VEDA-4th-Team5/STM/STM/Core/Src/main.c

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
/* Includes ------------------------------------------------------------------*/
#include "main.h"
#include "cmsis_os.h"
#include "adc.h"
#include "dma.h"
#include "tim.h"
#include "usart.h"
#include "gpio.h"

/* USER CODE BEGIN Includes */
#include <stdio.h>
#include "arm_math.h"
#include <stdlib.h>
#include "sensor_queue.h"
#include "sensor_protocol.h"
#include "alert_command.h"
#include "lora_e22.h"
#include "lora_frame.h"
/* USER CODE END Includes */


/* USER CODE BEGIN PV */
volatile uint32_t tim2_tick_count = 0;

#define ADC_BUF_SIZE 64
uint16_t adc_buf[ADC_BUF_SIZE];
/* USER CODE END PV */

void SystemClock_Config(void);
void MX_FREERTOS_Init(void);
/* USER CODE BEGIN 0 */
int __io_putchar(int ch)
{
    HAL_UART_Transmit(&huart2, (uint8_t*)&ch, 1, HAL_MAX_DELAY);
    return ch;
}

/* Fires (from ISR context) every time the circular DMA buffer wraps, i.e.
 * once per full 1-second/64-sample window. Just signals TaskFlameSensor -
 * no heavy work here since we're in an interrupt handler. */
void HAL_ADC_ConvCpltCallback(ADC_HandleTypeDef *hadc)
{
  if (hadc->Instance == ADC1)
  {
    osSemaphoreRelease(adcBufReadySemHandle);
  }
}

/* Fires (from ISR context) on either edge of any of the 4 hall D0 pins.
 * Same shape as HAL_ADC_ConvCpltCallback above: just wake TaskHallSensor,
 * no debouncing or UART work here. Which of the 4 slots changed isn't
 * tracked -- the task re-scans all 4 on wake, same as the old poll loop
 * did every tick. */
void HAL_GPIO_EXTI_Callback(uint16_t GPIO_Pin)
{
  if (GPIO_Pin == HALL1_D0_Pin || GPIO_Pin == HALL2_D0_Pin ||
      GPIO_Pin == HALL3_D0_Pin || GPIO_Pin == HALL4_D0_Pin)
  {
    osSemaphoreRelease(hallEdgeSemHandle);
  }
}

/* Fires (from ISR context) once per received USART2 byte -- the link runs
 * one-byte-at-a-time interrupt mode (see AlertCommand_StartReceive()), not
 * DMA, since AlertCommand traffic is short and infrequent. All the actual
 * buffering/parsing is delegated to alert_command.c; this callback only
 * exists because HAL_UART_RxCpltCallback has to live somewhere, same as
 * HAL_ADC_ConvCpltCallback and HAL_GPIO_EXTI_Callback above. */
void HAL_UART_RxCpltCallback(UART_HandleTypeDef *huart)
{
  if (huart->Instance == USART2)
  {
    AlertCommand_OnByteReceived();
  }
  else if (huart->Instance == USART1)
  {
    /* LoRa 하행. 여기서는 링버퍼에 넣기만 하고, 프레임 조립과 CRC 검증은
     * StartDefaultTask 가 태스크 문맥에서 한다 -- USART2 경로가 파싱을
     * 태스크로 미루는 것과 같은 이유다. */
    LoRa_OnByteReceived();
  }
}

/* 수신 에러(주로 오버런/프레이밍)가 나면 HAL 은 수신을 중단하고 *재무장하지
 * 않는다.* 그대로 두면 그 순간부터 하행이 조용히 죽는다 -- 로그도 안 남고
 * 송신은 멀쩡해서 원인을 찾기 어렵다. 여기서 다시 걸어준다.
 *
 * 오버런은 인터럽트가 잠깐 지연되면(예: 송신 중 스케줄러 정지 구간) 실제로
 * 발생한다. 이 콜백이 없으면 몇 시간 안에 반드시 겪는다. */
void HAL_UART_ErrorCallback(UART_HandleTypeDef *huart)
{
  if (huart->Instance == USART2)
  {
    __HAL_UART_CLEAR_OREFLAG(huart);
    AlertCommand_StartReceive();
  }
  else if (huart->Instance == USART1)
  {
    __HAL_UART_CLEAR_OREFLAG(huart);
    LoRa_StartReceiveIT();
  }
}
/* USER CODE END 0 */

/**
  * @brief  The application entry point.
  * @retval int
  */
int main(void)
{
  /* MCU Configuration--------------------------------------------------------*/

  /* Reset of all peripherals, Initializes the Flash interface and the Systick. */
  HAL_Init();

  /* Configure the system clock */
  SystemClock_Config();

  /* Initialize all configured peripherals */
  MX_GPIO_Init();
  MX_DMA_Init();
  MX_ADC1_Init();
  MX_USART2_UART_Init();
  MX_TIM2_Init();
  /* USER CODE BEGIN 2 */
#if LORA_BURN_MODULE
  /* Pi 쪽 모듈처럼 MCU 없이 동작할 모듈을 준비하는 전용 모드.
   * 굽고 확인한 뒤 여기서 멈춘다 -- 센서 노드로 동작하지 않으므로 이 모드를
   * 켜둔 채 잊어버려도 바로 알아차릴 수 있다. */
  LoRa_Init();
  printf("\r\n");
  printf("##################################################\r\n");
  printf("#  LORA BURN MODE -- 센서 동작 안 함              \r\n");
  printf("#  주소 0x%04X / NETID 0x%02X                     \r\n",
         (unsigned)LORA_BURN_ADDRESS, (unsigned)LORA_BURN_NETID);
  printf("#  ch=%u / 10dBm / LBT on / 62.5k / 115200        \r\n",
         (unsigned)LORA_CH_DATA_DEFAULT);
  printf("#  C0(영구 저장) -- 전원 끊어도 유지됨            \r\n");
  printf("##################################################\r\n");

  {
    HAL_StatusTypeDef burn_st = LoRa_BurnModule(LORA_BURN_ADDRESS, LORA_BURN_NETID);

    if (burn_st == HAL_OK)
    {
      printf("\r\n[burn] 완료. 되읽기 대조까지 통과했습니다.\r\n");
      LoRa_SelfTest();   /* 최종 상태를 디코드해서 한 번 더 남긴다 */
      printf("\r\n이 모듈을 대상 보드로 옮기고, LORA_BURN_MODULE 을 0 으로\r\n");
      printf("되돌린 뒤 재빌드하세요.\r\n");
    }
    else
    {
      printf("\r\n[burn] 실패. 모듈을 옮기지 마세요.\r\n");
      printf("배선(모듈TXD->PA10 / 모듈RXD->PA9 / M0->PC7 / M1->PB6 / AUX->PA7 / 3V3 / GND) 확인 후 재시도.\r\n");
    }

    /* 센서 동작으로 넘어가지 않는다. LED 로 결과를 표시하며 정지:
     * 느린 깜빡임 = 성공, 빠른 깜빡임 = 실패. */
    for (;;)
    {
      HAL_GPIO_TogglePin(LD2_GPIO_Port, LD2_Pin);
      HAL_Delay((burn_st == HAL_OK) ? 1000 : 150);
    }
  }
#endif

  /* 빌드 배너.
   *
   * 플래시가 실제로 새 빌드로 갈렸는지 로그만 보고는 알 수 없어서, 옛 펌웨어를
   * 돌리며 "왜 새 기능이 안 보이지" 를 몇 번 반복했다. 부팅할 때마다 빌드
   * 시각과 켜져 있는 기능을 찍어두면 그 혼선이 사라진다. */
  printf("\r\n======================================================\r\n");
  /* 보드 이름은 하드코딩하지 않는다. STM1/STM2 펌웨어가 같은 코드라
   * 여기가 고정이면 두 보드가 똑같은 이름으로 찍혀서, 어느 쪽 로그를 보고
   * 있는지 헷갈린다. 콘솔이 두 개 열려 있을 때 특히 위험하다. */
  printf("# %s  build %s %s\r\n", SENSOR_NODE_ID, __DATE__, __TIME__);
  printf("# payload v1.1 (frame ver 0x%02X) / node %s\r\n",
         (unsigned)LORA_FRAME_VERSION, SENSOR_NODE_ID);
  printf("# TX  uart=%d lora=%d   LoRa ch=%u pwr=10dBm lbt=%d\r\n",
         SENSOR_TX_UART, SENSOR_TX_LORA,
         (unsigned)LORA_CH_DATA_DEFAULT, LORA_LBT_ENABLE);
  printf("# 홀 쿨다운 %lums / 화재 텔레메트리 %lums\r\n",
         (unsigned long)SENSOR_HALL_COOLDOWN_MS,
         (unsigned long)SENSOR_FLAME_TELEMETRY_MS);
  printf("======================================================\r\n");

#if SENSOR_TX_LORA
  /* USART1(PA9/PA10)과 M0/M1/AUX(PC7/PB6/PA7) 초기화를 드라이버가 직접 하므로
   * .ioc 를 건드리지 않는다 -- CubeMX 재생성에도 안전하다.
   * 채널/출력/LBT 는 C0 명령으로 모듈에 영구 저장되어 있지만, 다른 모듈로
   * 교체했을 때를 대비해 부팅할 때마다 한 번 더 맞춰준다.
   * 주의: LoRa_SelfTest()/LoRa_Diag() 는 printf 로 USART2 에 찍는데 그건
   * Pi 데이터 링크라 프로토콜을 오염시킨다. 브링업 때만 임시로 켤 것. */
  LoRa_Init();
  /* persist=false(C2) 로 매 부팅마다 맞춘다. C0 는 모듈 플래시에 쓰는 거라
   * 부팅마다 때리면 수명을 깎는다. STM32 가 붙어 있는 쪽은 어차피 매번
   * 설정하므로 임시 저장으로 충분하다.
   * !! Pi 쪽 모듈은 MCU 가 없어서 스스로 설정하지 못한다. 그 모듈은 이
   *    보드에 잠깐 물려서 persist=true 로 한 번 구워서 넘겨야 한다. */
  {
    HAL_StatusTypeDef lora_st =
        /* LBT 는 KC 기술기준 항목이라 켜둔다. 브링업 중 링크가 안 붙을 때
         * 잠깐 false 로 내려 원인에서 배제하는 데 썼는데, 진단이 끝났으므로
         * 되돌렸다. LBT 가 송신을 미뤄도 STM32 에 알려주지는 않으므로,
         * "LORA OK" 는 UART 로 넘겼다는 뜻이지 전파가 나갔다는 보장은 아니다. */
        LoRa_ConfigureFull(LORA_CH_DATA_DEFAULT, LORA_PWR_10DBM, LORA_LBT_ENABLE,
                           LORA_AIR_PROJECT, LORA_UART_PROJECT, false);
    /* 이 두 줄은 디버그 플래그와 무관하게 항상 찍는다.
     *
     * 설정 확인에 실패하면 전파법 인터록이 송신을 전부 막는데, 그때 수신은
     * 계속 된다 -- 모듈이 저장된 설정으로 동작하기 때문이다. 그래서 겉보기엔
     * "명령은 받는데 갑자기 송신만 안 되는" 상태가 되고, 로그가 없으면
     * 원인을 짚을 수가 없다. 실제로 그 상황을 겪었다.
     *
     * 부팅 때 한 번 나가는 몇 줄이라 비용이 없다. */
    printf("\r\n# LORA CFG %s (ch=%u pwr=10dBm lbt=%d air=62.5k uart=115200)\r\n",
           (lora_st == HAL_OK) ? "OK" : "FAIL -- 송신 차단됨(인터록)",
           (unsigned)LORA_CH_DATA_DEFAULT, LORA_LBT_ENABLE);
    if (lora_st == HAL_OK) { LoRa_DumpRegisters(); }

    /* AUX 상태. 설정이 멀쩡한데 송신만 안 될 때 남은 후보가 이것이다.
     *
     * AUX 가 GND 로 눌려 있으면 모듈이 영원히 "바쁨" 으로 읽혀서, 매 송신마다
     * LoRa_WaitAuxIdle() 이 타임아웃(2초)을 다 쓰고 나간다. 로그상 송신은
     * 시도되는데 실제로는 거의 안 나가는 것처럼 보인다.
     *
     * 지금 레벨이 LOW 인데 모듈이 idle 이어야 할 상황이면 배선을 의심할 것.
     * detected=no 는 배선이 아예 안 붙었다는 뜻이고, 그 경우는 풀업 덕분에
     * 항상 HIGH 로 읽혀 동작에는 지장이 없다. */
    printf("# LORA AUX: level=%s  detected=%s  (PA7/D11)\r\n",
           (HAL_GPIO_ReadPin(LORA_AUX_GPIO_Port, LORA_AUX_Pin) == GPIO_PIN_SET)
               ? "HIGH(idle)" : "LOW(busy)",
           LoRa_AuxDetected() ? "yes" : "no");

#if LORA_DEBUG_HEX
    if (lora_st == HAL_OK) { LoRa_CheckNormalMode(); }
#endif
    if (lora_st != HAL_OK)
    {
      /* 설정이 안 먹었으면 어디서 막혔는지 자동으로 훑는다. 라인 프로브 ->
       * 단락 검사 -> baud 스윕 -> USART 우회 비트뱅잉 순서. 지그에서 E22 를
       * E220 으로 착각해 딥슬립에 빠뜨렸던 그 상황을 잡으려고 만든 루틴이다. */
      LoRa_SelfTest();
      LoRa_CheckNormalMode();
      LoRa_DetectVariant();
      LoRa_Diag();
    }
  }
#endif
  /* USER CODE END 2 */

  /* Init scheduler */
  osKernelInitialize();  /* Call init function for freertos objects (in freertos.c) */
  MX_FREERTOS_Init();

  /* USER CODE BEGIN RTOS_PERIPH_START */
  /* adcBufReadySemHandle must exist before conversions can start firing the callback */
  HAL_TIM_Base_Start_IT(&htim2);
  HAL_ADC_Start_DMA(&hadc1, (uint32_t*)adc_buf, ADC_BUF_SIZE);
  /* AlertCommand_Init() (freertos.c, RTOS_TIMERS above) already created the
   * semaphore/timers a received line needs, so it's safe to start taking
   * bytes now. */
  /* 태스크/큐/타이머가 전부 만들어진 뒤라야 힙 사용량이 의미가 있다.
   * 배너(위 USER CODE 2)에서 찍으면 아직 할당이 한 번도 없어 heap_4 가
   * 초기화되기 전이라 항상 0 이 나온다 -- 실제로 그걸로 한 번 오해했다. */
  printf("# FreeRTOS 힙 여유 %u / %u B (태스크 생성 후)\r\n",
         (unsigned)xPortGetFreeHeapSize(), (unsigned)configTOTAL_HEAP_SIZE);

  AlertCommand_StartReceive();

#if SENSOR_TX_LORA
  /* LoRa 인터럽트 수신 시작.
   *
   * 반드시 LoRa_ConfigureFull() 이 끝난 뒤여야 한다. 설정 모드는 블로킹
   * 수신(HAL_UART_Receive)을 쓰는데, 인터럽트 수신이 먼저 걸려 있으면
   * 같은 UART 를 두 방식이 다투게 되어 레지스터 응답을 놓친다.
   *
   * 이후로 STM1 은 항상 듣는 상태가 된다 -- Pi 가 언제 명령을 보내도
   * 받는다. 조립/CRC 검증은 StartDefaultTask 가 태스크 문맥에서 한다. */
  LoRa_StartReceiveIT();
#endif
  /* USER CODE END RTOS_PERIPH_START */

  /* Start scheduler */
  osKernelStart();

  /* We should never get here as control is now taken by the scheduler */
  /* Infinite loop */
  /* USER CODE BEGIN WHILE */
  while (1)
  {
    /* USER CODE END WHILE */

    /* USER CODE BEGIN 3 */
  }
  /* USER CODE END 3 */
}

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
/**
  * @brief  Period elapsed callback in non blocking mode
  * @note   This function is called  when TIM1 interrupt took place, inside
  * HAL_TIM_IRQHandler(). It makes a direct call to HAL_IncTick() to increment
  * a global variable "uwTick" used as application time base.
  * @param  htim : TIM handle
  * @retval None
  */
void HAL_TIM_PeriodElapsedCallback(TIM_HandleTypeDef *htim)
{
  if (htim->Instance == TIM1) {
    HAL_IncTick();
  }
  /* USER CODE BEGIN Callback 1 */
  if (htim->Instance == TIM2)
  {
      tim2_tick_count++;
  }
  /* USER CODE END Callback 1 */
}

/**
  * @brief  This function is executed in case of error occurrence.
  * @retval None
  */
void Error_Handler(void)
{
  /* USER CODE BEGIN Error_Handler_Debug */
  /* User can add his own implementation to report the HAL error return state */
  __disable_irq();
  while (1)
  {
  }
  /* USER CODE END Error_Handler_Debug */
}

#ifdef  USE_FULL_ASSERT
/**
  * @brief  Reports the name of the source file and the source line number
  *         where the assert_param error has occurred.
  * @param  file: pointer to the source file name
  * @param  line: assert_param error line source number
  * @retval None
  */
void assert_failed(uint8_t *file, uint32_t line)
{
  /* USER CODE BEGIN 6 */
  /* User can add his own implementation to report the file name and line number,
     ex: printf("Wrong parameters value: file %s on line %d\r\n", file, line) */
  /* USER CODE END 6 */
}
#endif /* USE_FULL_ASSERT */
