VEDA-4th-Team5/STM/STM/STM.ioc

Mcu.UserName=STM32F401RETx
PA0-WKUP.GPIO_Label=PLATE_LED1
PA0-WKUP.Signal=GPIO_Output
PA1.GPIO_Label=PLATE_LED2
PA1.Signal=GPIO_Output
PA13.GPIO_Label=TMS
PA13.Signal=SYS_JTMS-SWDIO
PA14.GPIO_Label=TCK
PA14.Signal=SYS_JTCK-SWCLK
PA2.GPIO_Label=USART_TX
PA2.Signal=USART2_TX
PA3.GPIO_Label=USART_RX
PA3.Signal=USART2_RX
PA4.GPIO_Label=PLATE_LED3
PA4.Signal=GPIO_Output
PA5.GPIO_Label=LD2 [Green Led]
PA5.Signal=GPIO_Output
PA8.GPIO_Label=HALL1_D0
PA8.Signal=GPIO_Input
PB0.GPIO_Label=PLATE_LED4
PB0.Signal=GPIO_Output
PB10.GPIO_Label=HALL2_D0
PB10.Signal=GPIO_Input
PB3.GPIO_Label=SWO
PB3.Signal=SYS_JTDO-SWO
PB4.GPIO_Label=HALL3_D0
PB4.Signal=GPIO_Input
PB5.GPIO_Label=HALL4_D0
PB5.Signal=GPIO_Input
PC0.GPIO_Label=FLAME_A0
PC0.Signal=ADCx_IN10
PC13-ANTI_TAMP.GPIO_Label=B1 [Blue PushButton]
PC13-ANTI_TAMP.Signal=GPXTI13
PC14-OSC32_IN.Signal=RCC_OSC32_IN
PC15-OSC32_OUT.Signal=RCC_OSC32_OUT
