VEDA-4th-Team5/STM/(commit log)

2026-07-20 chore: 초기 프로젝트 세팅 (FreeRTOS 및 CMSIS DSP 포함)
2026-07-21 feat: 홀센서 VACANT/OCCUPIED 상태머신 구현 (EVDA-78)
    CD4051 4채널 순회 폴링(50ms) + 채널별 디바운스(250ms 안정) 후 상태
    변화 시에만 이벤트를 큐로 발행하도록 TaskHallSensor 구현. 태스크 간
    공유용 SensorEvent_t/큐(sensorEventQueue)를 sensor_queue.h로 신설하고,
    CubeMX 코드 재생성 시 반복되는 MX_FREERTOS_Init() 버그(osThreadNew
    호출이 빈 헤더주석으로 대체되는 현상)를 복구.
2026-07-21 feat: 불꽃센서 FFT 에너지 계산 로직 구현 (EVDA-47)
    TaskFlameSensor에서 ADC DMA 완료 세마포어(adcBufReadySem)로 동기화
    후 adc_buf를 정규화하여 FFT 수행, bin 1~20(1~20Hz) magnitude 합산을
    에너지값으로 사용해 placeholder 임계값과 비교한 판정을 큐로 발행.
    main()의 임시 fft_test()는 제거하고 HAL_ADC_ConvCpltCallback으로
    대체했으며, 세마포어 생성(MX_FREERTOS_Init) 이후로 TIM/ADC 시작
    순서를 옮겨 커널 초기화 전 콜백 진입 레이스를 방지.
2026-07-21 feat: STM32-Pi UART 통신 프로토콜 구현 (EVDA-81)
    Raspberry Pi 팀이 이미 구현해둔 파서 형식(SENSOR:<id>:<state>:<seq>,
    FLAME:<id>:<verdict>:<seq>:<energy>)에 맞춘 sensor_protocol.h/.c 신설.
    TaskPacketTX가 sensorEventQueue에서 이벤트를 받아 타입별로 해당
    포맷 함수를 호출해 USART2로 송신하도록 구현. 원래 계획했던 바이너리
    프레임(STX/CRC-8/ETX)은 실제 소비 주체가 없어 채택하지 않음.
2026-07-21 fix: CMSIS-DSP 빌드 설정 및 클럭 소스 HSE 전환 (EVDA-120)
    .ioc 핀맵은 이미 HSE-External-Clock-Source(PH0/PH1)로 잡혀 있었으나
    실제 클럭 트리(main.c)는 HSI로 남아있던 불일치를 바로잡음: HSE
    bypass, PLLM=8로 변경(PLLN/PLLP는 그대로라 SYSCLK 84MHz 유지).
    .ioc도 동일하게 동기화.
    겸사겸사 .cproject의 CMSIS-DSP 빌드 설정 버그 2건도 수정:
    Debug 설정의 DSP include 경로가 이 프로젝트의 예전 위치로 하드코딩된
    절대경로였던 것을 상대경로로 변경했고, Release 설정엔 애초에
    ARM_MATH_CM4 정의/DSP include 경로/DSP Examples·TestSuite 제외
    필터가 빠져 있어 헤드리스 빌드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
    [STM1.ioc, main.c]
2026-07-21 chore: 레포 폴더 구조 추가 및 STM1 검증 기록 문서화
    STM2/docs/misc 스켈레톤 폴더 추가(다른 보드/문서/잡스크립트용
    자리, .gitkeep으로 커밋). 실물 센서 미도착 상태에서 STM1 보드만으로
    진행한 파이프라인 검증(불꽃 임계값 반응, 홀센서 디바운스, HSE 전환,
    개행 버그 수정 등) 결과를 docs/STM1_pipeline_test_2026-07-21.md에
    기록.
2026-07-21 docs: STM1 README 추가
    클럭/핀맵, 신호처리 파이프라인, FreeRTOS 태스크 구조, UART 프로토콜,
    CubeMX osThreadNew 버그, 현재 검증 상태를 정리한 프로젝트 README를
    STM1/에 신설.
2026-07-21 docs: 태스크 로직/UART 프로토콜/클럭 설정에 설명 주석 추가
    freertos.c의 홀센서 디바운스, 불꽃센서 FFT 에너지 계산, 큐/세마포어
    공유 구조, main.c의 ADC 콜백/HSE 클럭 설정, sensor_protocol.c/.h의
    UART 포맷 함수에 이해를 돕는 주석 보강. 동작 변경 없음(헤드리스
    빌드로 0 에러 재확인).
2026-07-21 fix: TaskFlameSensor 스택 부족 및 오버플로우 무방비 상태 수정 (EVDA-47)
    -fstack-usage로 확인해보니 StartTaskFlameSensor 자체 프레임만
    704B인데 할당 스택은 1024B(256*4)뿐이라, FFT 관련 함수/RTOS API
    호출분까지 합치면 여유가 거의 없었음. 512*4(2048B)로 늘림.
    configCHECK_FOR_STACK_OVERFLOW가 꺼져있어서 넘쳐도 조용히 다른
    메모리를 덮어쓰는 상태였음 — 2로 켜고 vApplicationStackOverflowHook
    추가(감지 시 Error_Handler 진입)해서 앞으로는 크래시로 드러나게 함.
2026-07-23 fix: 불꽃센서 ALERT 판정에 지속성(디바운스) 추가 (EVDA-47)
    라이터 실측 테스트에서 단일 윈도우(1초) 에너지값이 손떨림/거리 변화로
    1~20Hz 대역에서 튀는 현상 확인. 홀센서와 동일한 디바운스 패턴을 적용해
    3번 연속 윈도우가 같은 판정을 내야 ALERT/CLEAR 상태가 바뀌도록 수정.
    원시 에너지 값은 기존처럼 매 윈도우 전송(실측 캘리브레이션용).
2026-07-23 refactor: 불꽃센서 판정을 FFT flicker 방식에서 raw ADC 임계값 방식으로 변경 (EVDA-47)
    DFR0076 공식 예제(analogRead 후 그대로 출력)를 보면 이 센서는
    flicker(진동) 감지용이 아니라 단순 IR 세기 감지용 센서. FFT로 1~20Hz
    대역 에너지를 뽑는 방식은 손 떨림/거리 변화 노이즈를 flicker와
    구분하지 못해 임계값이 안정적으로 잡히지 않았음.
    부팅 직후 첫 윈도우 평균을 baseline으로 저장해두고, 이후 매 윈도우
    평균과의 편차(delta)가 FLAME_DELTA_THRESHOLD를 넘는지로 판정하도록
    변경. 디바운스(3연속 윈도우 일치)는 기존 구조 그대로 재사용.
    FLAME_DELT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
2026-07-23 fix: ADC1 샘플링 타임을 3→480 cycles로 상향 (EVDA-47)
    3 cycles(약 143ns)는 저임피던스 소스 전용 최소값이라, 센서 모듈 출력
    임피던스에서 sample-hold 커패시터가 다 충전되지 못해 값이 좁은 범위에
    눌리는 것으로 의심. 어차피 64Hz(15.6ms 간격)로만 변환하므로 여유
    충분해서 최대치인 480 cycles로 변경. (참고: 이후 실측 결과 근본 원인은
    PA0/PC0 배선 실수였음이 확인됐지만, 이 수정 자체는 유효한 개선이라 유지)
2026-07-23 fix: 불꽃센서 ALERT 판정에 FFT flicker + raw DC 레벨 하이브리드 방식 도입 (EVDA-47)
    실측 결과 FFT flicker 에너지는 점화/움직임 순간엔 강하게 반응하지만
    불꽃이 안정적으로 지속 연소하면 오히려 baseline 수준으로 가라앉는
    현상 확인(진짜 불꽃은 완전한 주기 진동이 아니라 카오틱하기 때문).
    반대로 raw ADC 평균(DC 레벨)은 반응은 느리지만 지속적인 IR 세기를
    안정적으로 반영함.
    두 신호를 OR로 결합: energy>=5.0(점화 트리거) 또는
    delta(baseline 대비 raw_avg 편차)>=40.0(지속 확인) 중 하나라도
    만족하면 해당 윈도우를 hit으로 카운트하고, 기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
2026-07-23 docs: STM1 마무리 정리 — README/신규 검증 문서, 죽은 코드/placeholder 주석 정리, .ioc 드리프트 및 .gitignore 수정 (EVDA-47)
    - freertos.c: StartDefaultTask의 죽은 디버그 printf 블록 제거,
    화염센서 임계값 주석을 실측 검증 완료 상태로 갱신(더 이상 placeholder 아님)
    - STM1.ioc: ADC1 SamplingTime을 실제 코드(480 cycles)와 동기화
    (3 cycles로 남아있으면 CubeMX 재생성 시 되돌아갈 위험)
    - .gitignore: STM32CubeIDE 헤드리스 빌드용 워크스페이스(.cubeide_ws_build/) 제외
    - README.md: 하이브리드 판정 알고리즘(FFT flicker OR raw DC 레벨 + K-of-N
    디바운스)로 "신호 처리" 섹션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
    [STM1.ioc]
2026-07-24 feat: PuTTY용 ANSI 대시보드 디버그 UI 모드 추가 (EVDA-47)
    SENSOR_DEBUG_UI(sensor_protocol.h)를 1로 켜면 원본 SENSOR:/FLAME:
    프로토콜 라인 대신, 홀센서 4채널 + 화염센서 상태를 색상 강조와 함께
    화면 제자리 갱신으로 보여주는 ANSI 대시보드를 출력. Pi가 파싱 못하는
    화면이라 로컬 PuTTY 테스트 전용 — 기본값은 0(원본 프로토콜 유지)이라
    Pi 연동에는 영향 없음.
2026-07-24 docs: STM1 최종 요약 문서 추가 (실물 캡처 포함) (EVDA-47, EVDA-78, EVDA-81, EVDA-120)
    CubeMX 초기 설정, 홀센서 비교기 회로(고정저항 분압기 설계 및 D0 반대
    극성 발견, printf 레이스 컨디션 디버깅 포함), 화염센서 하이브리드
    판정 알고리즘 재설계 과정, UART 프로토콜까지 전체 스토리를 실제
    캡처 이미지와 함께 한 문서로 정리.
2026-07-28 [Fix] STM1 CMSIS-DSP 빌드와 HSE 클럭 설정 정합성 수정 (EVDA-120) (#9)
    * fix: CMSIS-DSP 빌드 설정을 Debug와 Release에 동일하게 적용 (EVDA-120)
    * fix: STM1 시스템 클럭을 HSE 84MHz 설정과 동기화 (EVDA-120)
    * chore: CubeIDE 빌드 워크스페이스를 Git 추적에서 제외
    * docs: STM1 클럭 및 핀 설정 캡처 추가 (EVDA-120)
    ---------
2026-07-31 refactor: 홀센서 CD4051 제거 및 4채널 GPIO 직결 전환 (EVDA-155) (#10)
    4채널 브링업에서 CD4051을 경유하면 미감지 상태에도 4채널 전부 OCCUPIED로
    고착되는 현상이 재현됨. D0를 GPIO에 직결하면 정상 동작하는 것을 실측 확인해
    멀티플렉서를 제거한다.
    - 핀: MUX_A/MUX_B/MUX_COM 제거 -> PA0/PA1/PA4/PB0을 HALL1~4_D0로 재배치
    - D0가 오픈컬렉터라 내부 pull-up 사용, LOW를 OCCUPIED로 판정
    - TaskHallSensor에서 채널 순회 및 settle delay 로직 제거
    - .ioc 동기화로 CubeMX 재생성 시 핀 설정 롤백 방지
2026-07-31 fix: UART 센서 프로토콜을 Pi 파서 규격에 정합 (EVDA-156) (#11)
    STM32가 보내던 포맷이 Pi SensorProtocolParser의 기대값과 달라 파싱되지
    않던 문제를 수정한다.
    - SENSOR:sensor_0N:... -> SENSOR:HALL01~04:OCCUPIED|VACANT:<seq>
    - FLAME:flame_01:ALERT|CLEAR -> FIRE:FLAME01:DETECTED|CLEARED:<seq>
    - 센서 ID를 Pi의 config/parking_slots.json 및 FIRE_SENSOR_SLOT_MAP과 일치
    - energy 필드는 파서에 대응 항목이 없어 전송에서 제외하고,
    임계값 재튜닝용 FLAME_DEBUG_ENERGY 플래그(기본 꺼짐)로만 출력
    [sensor_protocol.c, sensor_protocol.h]
2026-07-31 fix: 불꽃센서 부팅 baseline 고착 버그 수정 및 임계값 실측 재조정 (EVDA-157) (#12)
    부팅 직후 첫 윈도우를 그대로 ambient baseline으로 확정하던 탓에, 그 값이
    낮게 잡히면 평상시 ambient가 임계값 이상 떠서 불이 없는데도 DETECTED로
    고착되고, 상태가 더는 바뀌지 않아 엣지 이벤트도 안 나가는 문제가 있었다.
    - 첫 3창 폐기(센서/ADC settle) 후 다음 3창 평균을 baseline으로 사용
    - FLAME_DELTA_THRESHOLD 40 -> 300
    실측: 평상시 delta 0~ 12 / 불꽃 delta 1427~4042
    기존 40은 평상시 대비 3배뿐이라 baseline이 조금만 치우쳐도 오탐 위험
    - FLAME_ENERGY_THRESHOLD 5.0 유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
2026-08-03 [Fix] 홀센서 1초 주기 전송 및 화재 엣지 트리거 전송 정책 분리 (EVDA-158) (#14)
    Pi와 합의된 인터페이스 계약(EVDA-134)과 어긋나게 동작하던 전송 정책을
    스트림별로 바로잡는다.
    - 화재: 매 1초 ADC 윈도우마다 상태 변화와 무관하게 이벤트를 발행하던 것을
    확정 판정이 실제로 뒤집힐 때만 발행하도록 수정. 부팅 후 첫 확정값은
    기준값으로만 저장해 콜드부팅 시 불필요한 CLEARED가 나가지 않게 함
    (같은 문제가 Keil 트리에도 있었고 EVDA-150에서 별도 수정됨)
    - 홀센서: 상태 변화 시에만 보내던 것을 1초 주기로 4채널 전부 보고하도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
    [sensor_protocol.h]
2026-08-07 [Feat] 홀센서/화재감지 GPIO 폴링 -> EXTI 인터럽트 전환 및 리포트 정책 개선 (EVDA-140) (#15)
    - 홀센서 4채널을 50ms osDelay 폴링에서 GPIO EXTI(양쪽 엣지) 인터럽트 기반으로 전환.
    ISR은 세마포어만 릴리즈하고 디바운스/판정은 태스크에서 처리 (TaskFlameSensor의
    ADC 콜백 패턴과 동일).
    - 홀센서 리포트: 1초 고정 하트비트 -> 상태 변화 시 즉시 전송 + 30초 생존 하트비트로 분리.
    - 화재감지에도 동일하게 30초 생존 하트비트 추가 (변화 시 즉시 전송 로직은 유지).
    - 홀센서 핀 재배치: HALL1~4를 PA8/PB10/PB4/PB5로 변경, EXTI 라인 번호 충돌 회피.
    Co-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
2026-08-07 [Feat] 번호판 조명 LED 수신부 구현 (EVDA-194) (#16)
    * WIP: 번호판 LED GPIO 핀 배정 및 설계 문서
    PA0/PA1/PA4/PB0을 PLATE_LED1~4(Output)로, 기존 홀센서는 PA8/PB10/PB4/PB5로
    재배치. origin/develop의 EVDA-140(GPIO->EXTI 전환)이 실제 코드에서 이미 같은
    핀으로 옮겨뒀음을 병합 전 확인함.
    * feat: 번호판 조명 LED 수신부 구현 (EVDA-194)
    Pi의 ALERT:<sensorId>:LED:ON/OFF:<seq> 명령을 USART2로 받아 PLATE_LED1~4
    (PA0/PA1/PA4/PB0)를 구동한다. 1바이트 인터럽트 수신 + 링버퍼로 완성된 라인마다
    세마포어를 올리고, 새 TaskCommandRX가 그 라인을 파싱해 GPIO 토글과
    슬롯별 5초 페일세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
2026-08-10 [Feat] STM1 LoRa 무선 전송 구현 — 홀/불꽃 센서 이벤트 (EVDA-46) (#17)
    * feat: E22 LoRa 드라이버 및 Pi 규격 프레임 인코더 추가 (EVDA-46)
    E22-900T22S(1B) 를 고정점(fixed-point) 모드로 운용하는 드라이버와,
    Pi_Server docs/UART_LORA_PROTOCOL.md 규격 프레임 인코더를 추가한다.
    투명 모드가 아니라 고정점을 쓴 이유:
    투명 모드는 송·수신 모듈의 주소가 같아야 동작한다. 노드를 구분하려고
    주소를 다르게 구우면 그 순간 링크가 끊긴다. 고정점은 프레임 앞에
    목적지 <ADDH ADDL CH> 3 byte 를 붙이므로 주소가 실제 의미를 갖는다.
    브링업에서 걸린 함정들:
    -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
    [lora_e22.c, lora_e22.h, lora_frame.c, lora_frame.h, main.c, sensor_protocol.c, sensor_protocol.h]
2026-08-13 [Feat] 센서 페이로드 v1.1 및 LoRa 양방향 통신 — 2노드 구성 (EVDA-46) (#18)
    * feat: 센서 페이로드 v1.1 및 LoRa 하행 수신 (EVDA-46)
    상행 규격을 v1.1 로 올리고, Pi 가 STM 으로 명령을 보낼 수 있도록 하행
    경로를 만든다. 프레임 version 을 0x02 로 올려 수신측이 구/신을 동시에
    받을 수 있게 했다 -- STM 과 Pi 를 같은 순간에 배포할 필요가 없어진다.
    ## 페이로드 v1.1
    SENSOR:STM1:HALL01:OCCUPIED:142
    FIRE:STM1:FLAME01:DETECTED:144:43.70
    - 노드 ID 추가. 고정점 주소는 모듈이 떼어내므로 수신측에 오지 않는다.
    STM2 가 붙으면 센서 이름이 겹치지 않는다는 약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
2026-08-14 [Fix] LoRa 부팅 진단 로그 상시화 및 Pi 구축 가이드 추가 (EVDA-46) (#19)
    * fix: LoRa 설정/AUX 상태를 디버그 플래그와 무관하게 항상 남긴다 (EVDA-46)
    설정 확인에 실패하면 전파법 인터록이 송신을 전부 막는다. 그런데 그때도
    수신은 계속 된다 -- 모듈이 저장된 설정으로 동작하기 때문이다. 겉보기엔
    "명령은 잘 받는데 갑자기 송신만 안 되는" 상태가 된다.
    그 상태를 실제로 겪었는데, 관련 로그가 전부 LORA_DEBUG_HEX 안에 있어서
    꺼둔 상태에서는 인터록 여부조차 확인할 수 없었다. 원인을 좁히려고 플래그를
    켜고 재빌드·재플래시하는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
    [main.c]
2026-08-19 [Feat] STM2 노드 추가 + STM1/STM2 프로젝트 통합 (EVDA-46) (#20)
    * chore: CMSIS-DSP 제외 규칙을 보드 경로에 묶지 않는다 (EVDA-46)
    규칙이 `STM1/` 로 시작해 있어서 폴더 이름이 바뀌면 그대로 깨진다.
    `**/` 로 바꿔 보드 폴더 이름과 무관하게 적용되게 한다.
    * refactor: STM1/STM2 프로젝트를 하나로 합친다 (EVDA-46)
    STM2 를 STM1 에서 복사해 만들었는데, 전체 diff 를 떠 보니 실제로 다른 것은
    파일 2개의 4줄이었다. 그 4줄 때문에 428개 파일이 두 벌 있었던 셈이다.
    문제는 용량이 아니라 조용히 갈라진다는 것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
2026-08-24 [Feat/Fix] 하트비트 10초 단축 및 화재 유실 대책 (EVDA-46, EVDA-218, EVDA-124) (#21)
    * docs: Pi 하행 송신 시 AUX 미연결 대응 절 추가 (EVDA-46, EVDA-201)
    서버 Pi 의 E22 AUX 는 연결돼 있지 않다. 수신만 할 때는 문제가 없었는데,
    노드가 둘이 되면서 하행이 실제 위험이 됐다.
    모듈은 UART 스트림이 멈추는 것을 패킷 경계로 쓴다. 그래서 프레임 두 개를
    간격 없이 write 하면 모듈이 둘을 한 패킷으로 붙인다. 목적지가 번갈아
    나가는 상황에서는 두 번째 프레임의 목적지 3바이트가 첫 패킷의 페이로드가
    되어, 한 노드는 CRC 실패로 버리고 다른 노드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
    [sensor_protocol.c, sensor_protocol.h]
2026-08-28 [Fix/Perf] 화재 판정 임계 재설정 및 플래시 59% 절감 (EVDA-218, EVDA-46) (#23)
    * perf: FFT 인스턴스를 직접 초기화해 미사용 twiddle 78KB 를 걷어낸다 (EVDA-46)
    arm_rfft_fast_init_f32() 는 Sint->fftLen 으로 switch 를 돌면서 지원하는
    모든 길이의 테이블을 참조한다. 분기 하나만 실행되지만 참조는 전부 남아
    -ffunction-sections/--gc-sections 로도 버려지지 않는다. 64포인트만 쓰는데
    4096포인트까지의 twiddle 이 통째로 링크돼 있었다.
    FFT 테이블 총합 78,936 B (텍스트 132,520 B 의 59.6%)
    실제 필요분 608 B
    인스턴스를 직접 채운다. 원본 함수의 case 32U 가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
