VEDA-4th-Team5/STM/(notices)

Notices in the files:
STM/Core/Inc/main.h:
Copyright (c) 2026 STMicroelectronics.
All rights reserved.
This software is licensed under terms that can be found in the LICENSE file
